GabrielLengertGuedes/IoT-Reservatorio/docs/arquitetura/diagrama_blocos.png

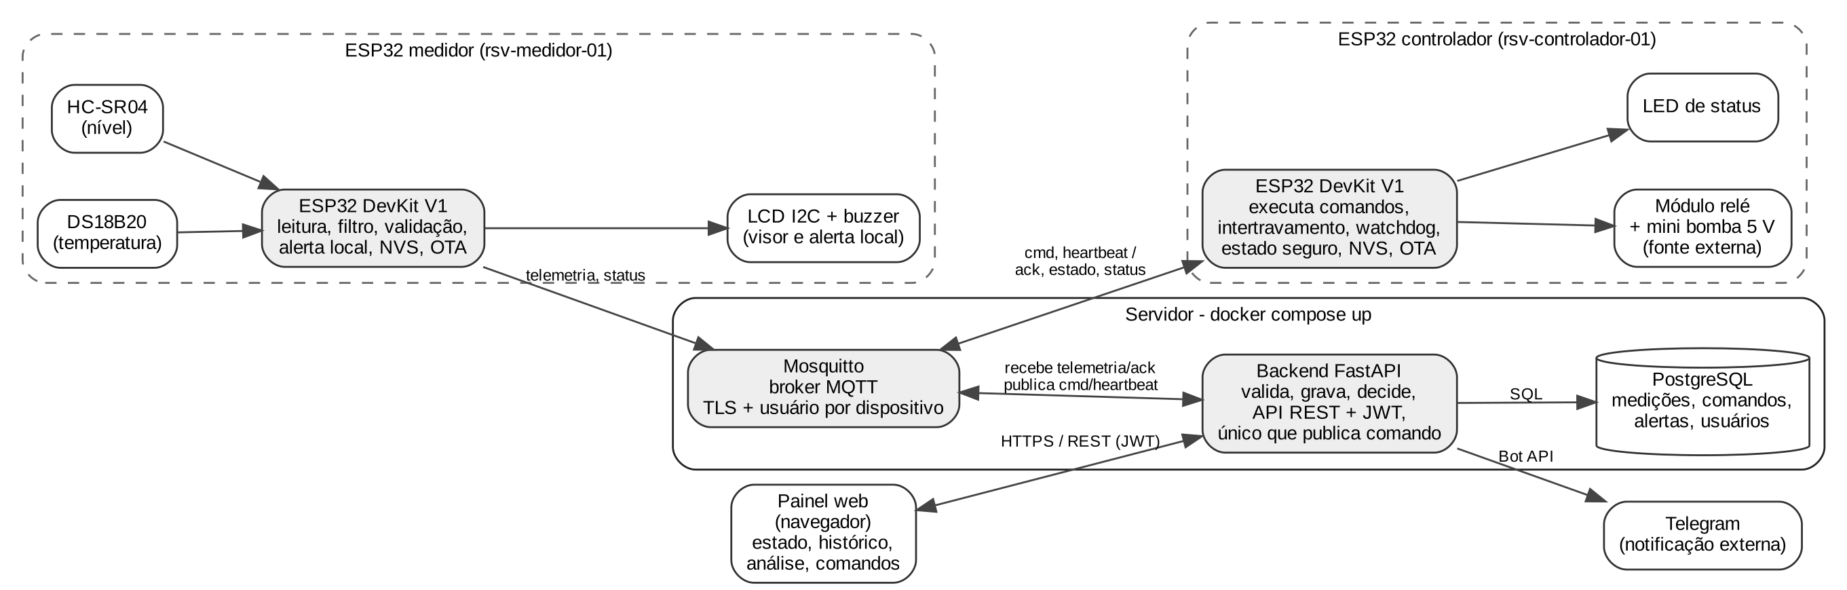
docs/arquitetura/diagrama_blocos.png
