GabrielLengertGuedes/IoT-Reservatorio/docs/arquitetura/fluxo_comando.png

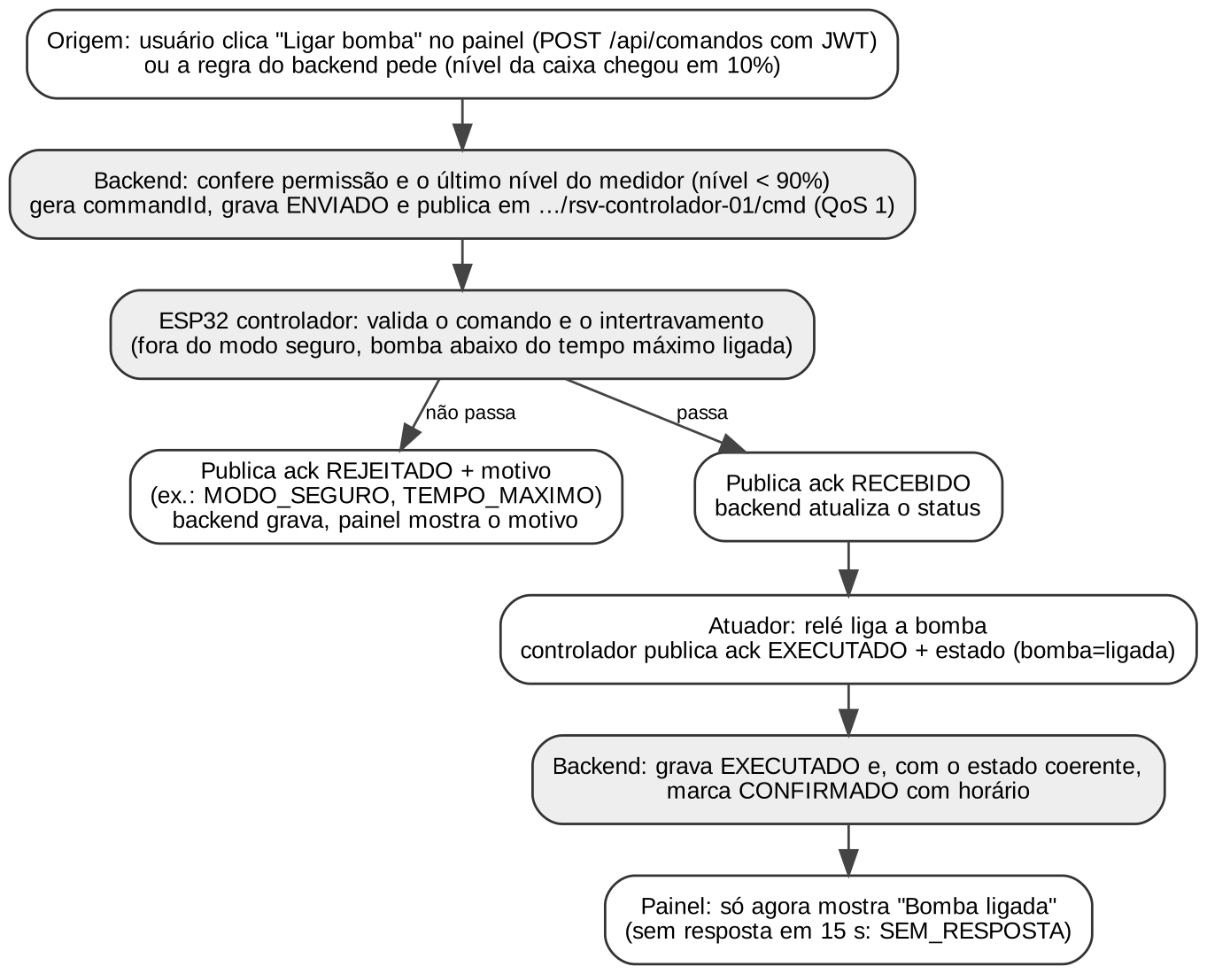
docs/arquitetura/fluxo_comando.png
