GabrielLengertGuedes/IoT-Reservatorio/docs/arquitetura/fluxo_dado.png

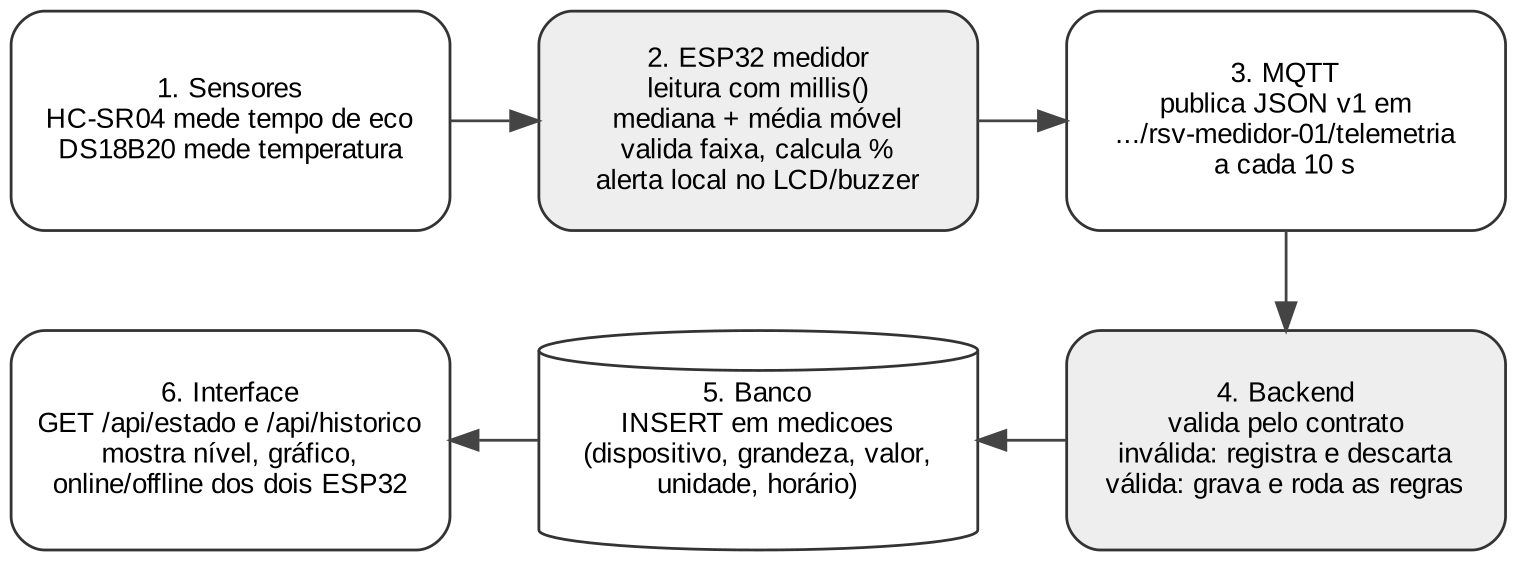
docs/arquitetura/fluxo_dado.png
