GabrielLengertGuedes/IoT-Reservatorio/docs/firmware/fluxograma_controlador.png

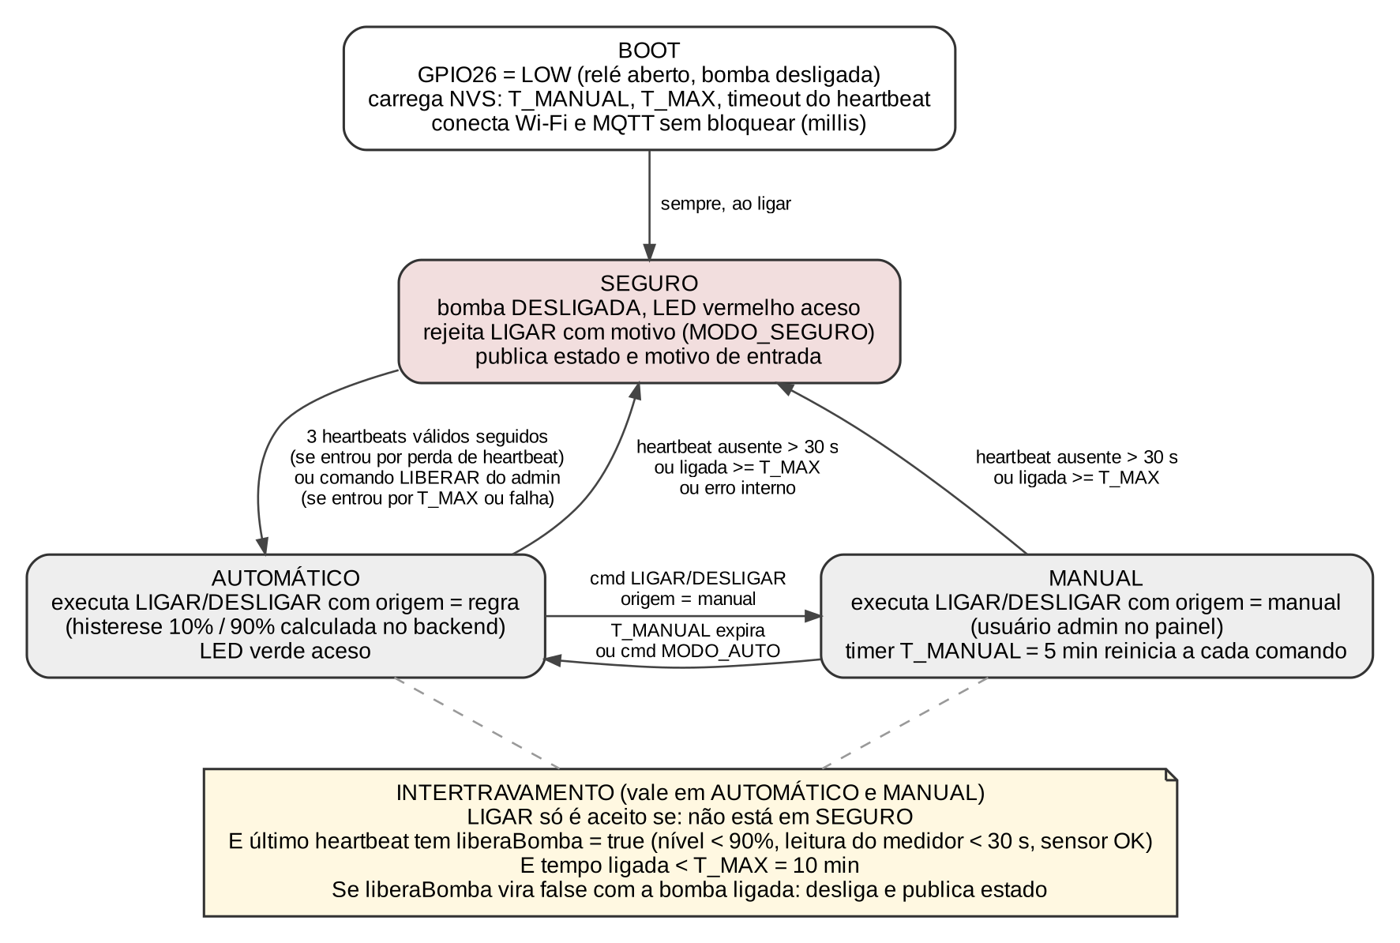
docs/firmware/fluxograma_controlador.png
