GabrielLengertGuedes/IoT-Reservatorio/docs/firmware/fluxograma_medidor.png

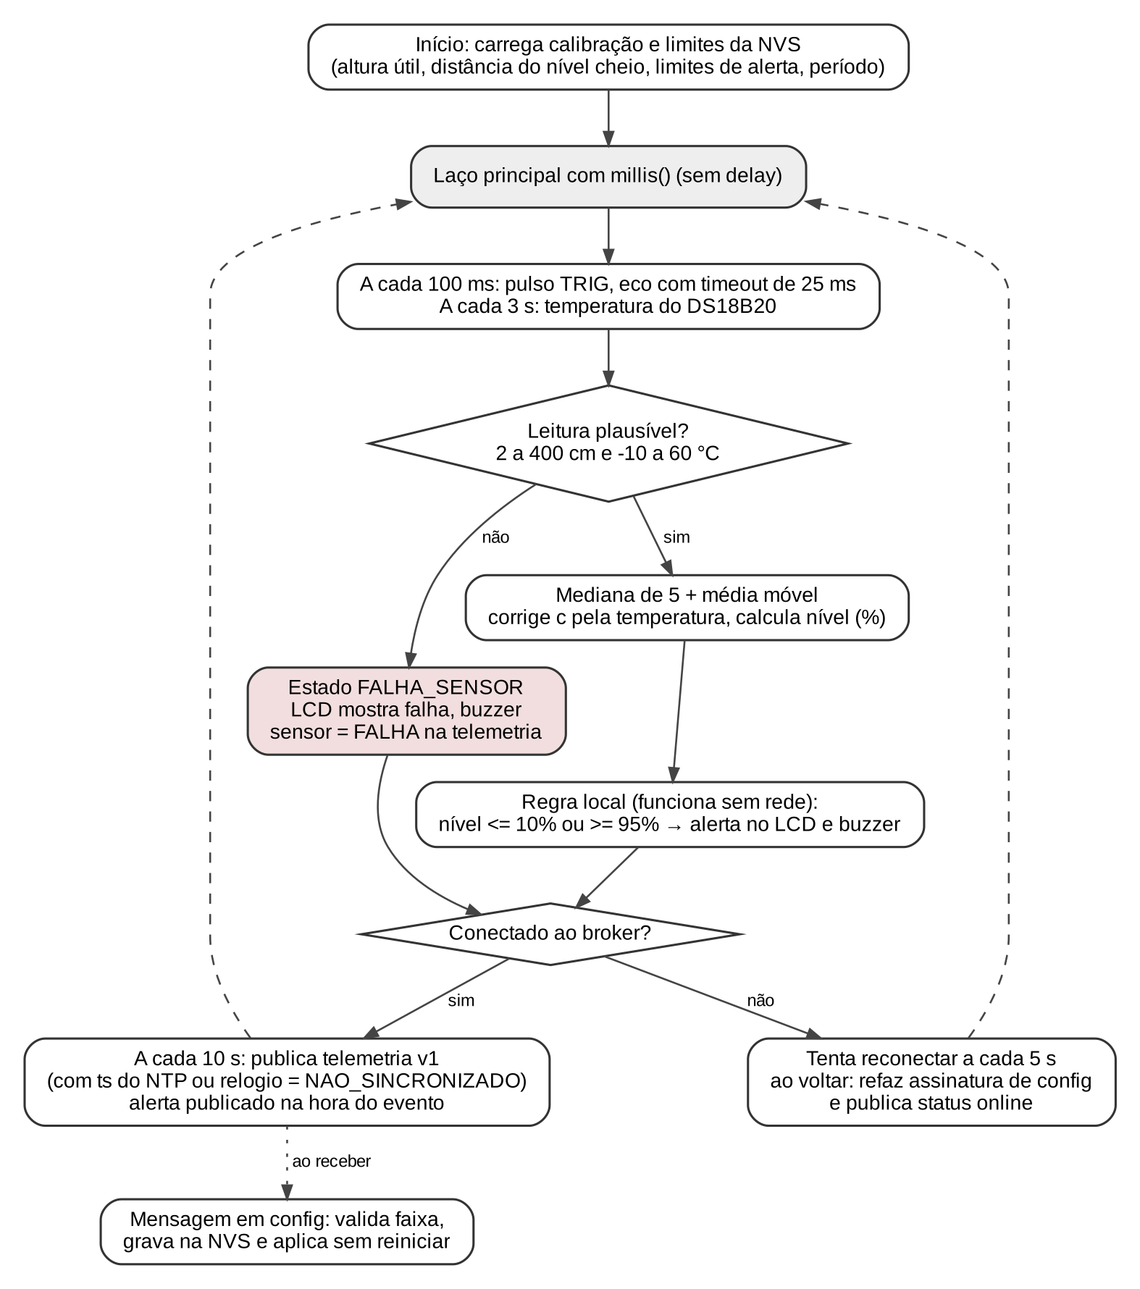
docs/firmware/fluxograma_medidor.png
