GabrielLengertGuedes/IoT-Reservatorio/docs/hardware/esquema_controlador.png

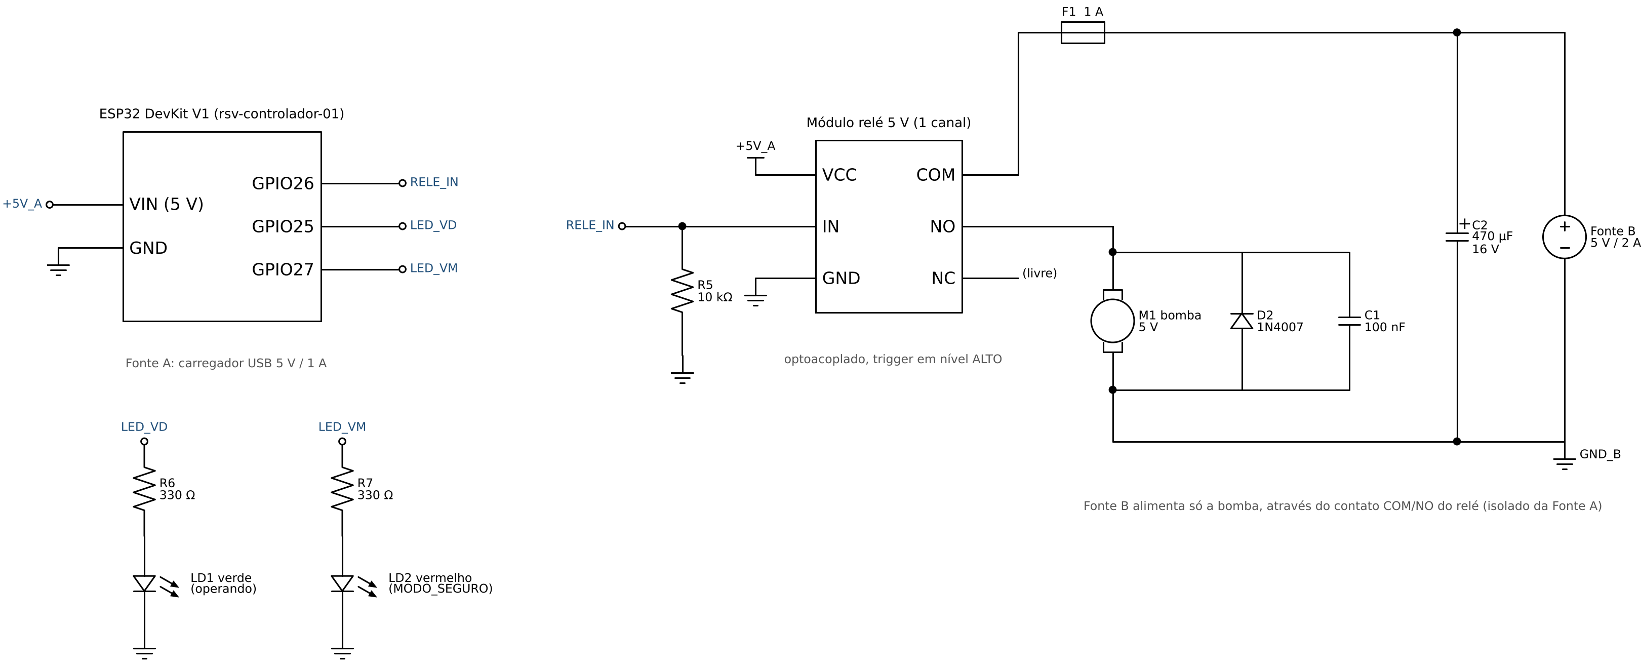
docs/hardware/esquema_controlador.png
