GabrielLengertGuedes/IoT-Reservatorio/docs/hardware/esquema_medidor.png

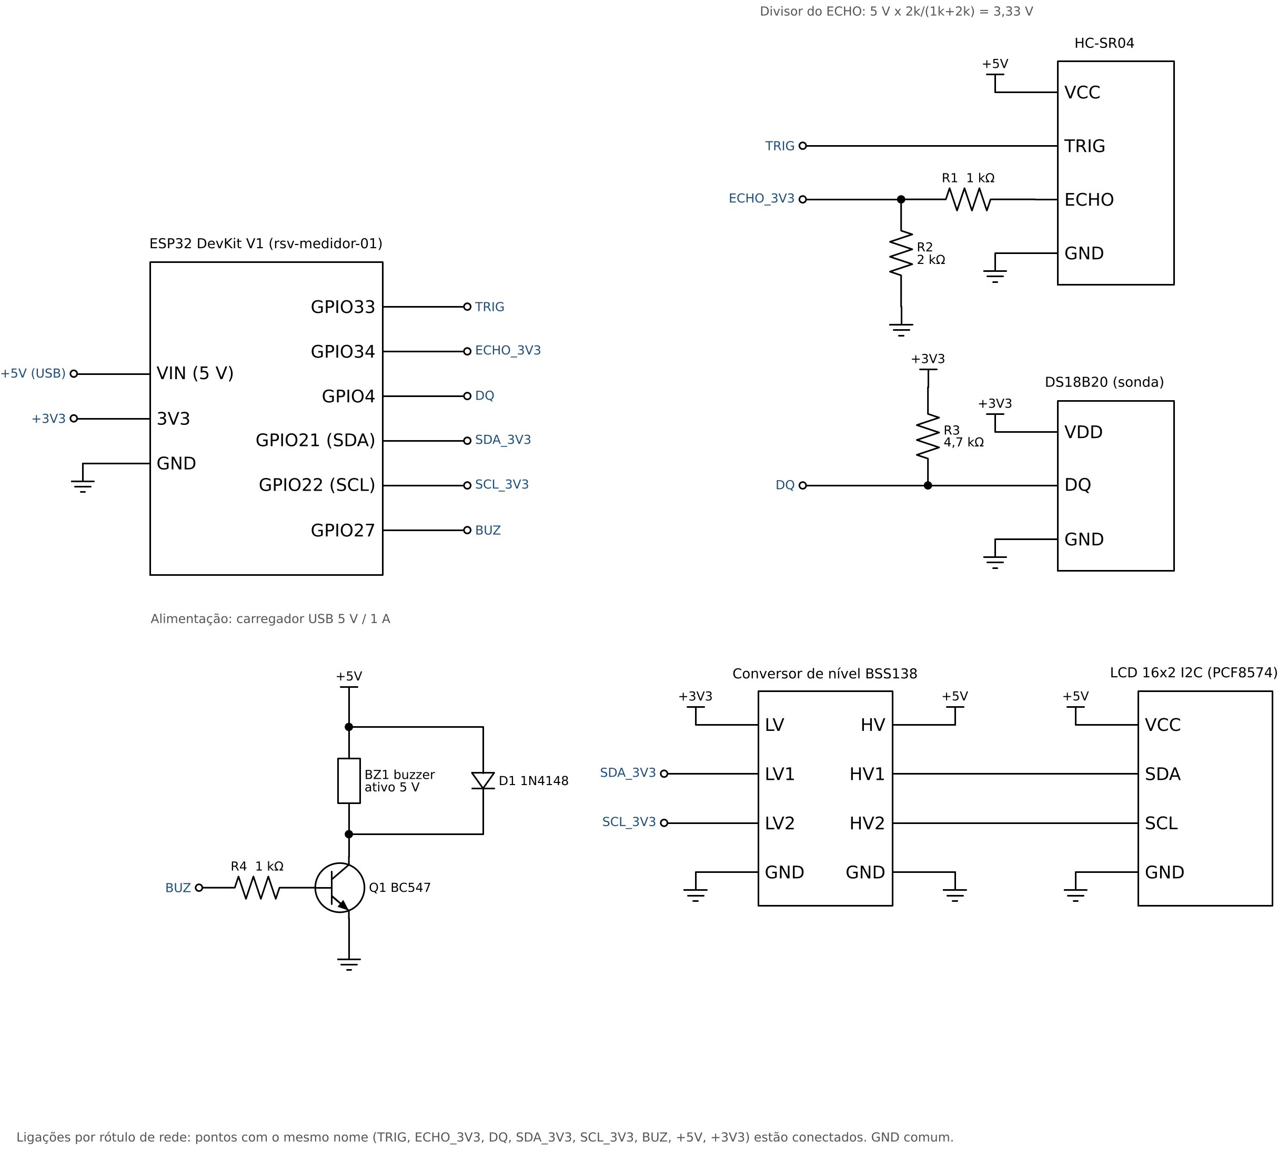
docs/hardware/esquema_medidor.png
