GabrielLengertGuedes/IoT-Reservatorio/(commit log)

2026-10-28 Add files via upload
    Adiciona diagramas, contrato v1, mapa de pinos e BOM do CP12
2026-10-28 Separa o firmware em dois ESP32: medidor e controlador
    - medidor/medidor.ino: o sketch da N1 sem a logica da bomba. Publica
    telemetria, alerta e status (Last Will) do contrato v1, com alerta local
    no LCD e no buzzer que funciona sem rede e calibracao na NVS pelo topico
    config. Mantem os topicos de texto da N1 durante a transicao.
    - controlador/controlador.ino: firmware novo com BOOT, SEGURO, AUTOMATICO e
    MANUAL, timeout de heartbeat, tempo maximo ligada, rejeicao de LIGAR em
    SEGURO, lista dos ultimos 8 commandId e parametros na NVS.
    - backend-teste/backend_teste.py: backend provisorio em paho-mqtt com
    heartbeat, histerese 10/90 e comandos pelo terminal.
    - compilar.sh aceita medid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
    [controlador.ino, medidor.ino]
2026-10-28 Reduz o tempo de reacao entre o nivel mudar e a bomba agir
    - Medidor: telemetria por evento quando o nivel varia 5 pontos, cruza 10 %
    ou 90 % ou o sensor muda entre OK e FALHA, com no minimo 1 s entre
    publicacoes. Periodo padrao de 10 s para 5 s.
    - Backend de teste: heartbeat imediato quando liberaBomba muda, antes de
    qualquer comando; histerese a cada telemetria e a cada estado; um novo
    cmd da regra so sai depois do EXECUTADO/REJEITADO do anterior (timeout
    de 5 s); log com milissegundos e latencia medida por comando.
    - TESTE-DOIS-ESP32.md: teste de tempo de reacao e pontos para a v2 do
    contrato.
2026-10-28 Margem no liberaBomba e docs de hardware com o rele JQC3F-03VDC
    - Backend de teste: liberaBomba bloqueia em 90 % (NIVEL_ALTO) e so volta
    a liberar em 87 %, com as duas constantes no topo do arquivo.
    - TESTE-DOIS-ESP32.md: margem registrada nos pontos para a v2 do contrato.
    - mapa_de_pinos.md e bom.md: rele JQC3F-03VDC com bobina de 3 V, DC+ no
    3V3 (cerca de 120 mA), DC- no GND, In1 no GPIO26 e jumper em High.
